SebCanet/CharlyRobotCRA4_Livet/Documentation/config grbl.png

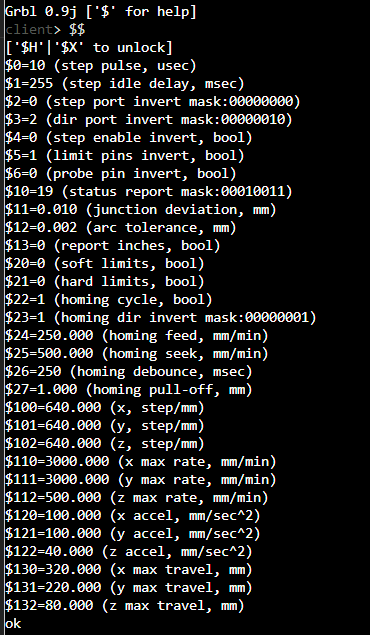
Documentation/config grbl.png
