SebCanet/CharlyRobotCRA4_Livet/Electronique/Circuit Imprimé/BOM/Liste composants.xlsx

ref | value5 | footprint | datasheet | lib | part | description | Référence Farnell
A1 | Arduino_Nano_v2.x | empreintes_CharlyRobot:Arduino_Nano | https://www.mouser.fr/datasheet/2/595/Arduino-ArduinoBoardNano-1214669.pdf | CharlyRobot | Arduino_Nano_v2.x | Arduino nano | 1848691
C1 | 1µF | empreintes_CharlyRobot:C_Rect_L7.0mm_W4.5mm_P5.00mm | http://www.farnell.com/datasheets/1955213.pdf | Device | C | Unpolarized capacitor | 1692372
C2 | 10µF | empreintes_CharlyRobot:CP_Radial_D5.0mm_P2.50mm | http://www.farnell.com/datasheets/1778119.pdf | Device | C | Polarized capacitor | 8766940
D2 | LED | empreintes_CharlyRobot:LED_D3.0mm | http://www.farnell.com/datasheets/2100363.pdf | Device | LED | Light emitting diode | 1863180 (https://www.mouser.fr/ProductDetail/Lumex/SSL-LX3044ID?qs=yJopvU1l2pYg0unLYeASnw%3D%3D&vip=1)
D3 | LED | empreintes_CharlyRobot:LED_D3.0mm | http://www.farnell.com/datasheets/2100363.pdf | Device | LED | Light emitting diode | 1863180 (https://www.mouser.fr/ProductDetail/Lumex/SSL-LX3044ID?qs=yJopvU1l2pYg0unLYeASnw%3D%3D&vip=1)
D5 | LED | empreintes_CharlyRobot:LED_D3.0mm | http://www.farnell.com/datasheets/2100363.pdf | Device | LED | Light emitting diode | 1863180 (https://www.mouser.fr/ProductDetail/Lumex/SSL-LX3044ID?qs=yJopvU1l2pYg0unLYeASnw%3D%3D&vip=1)
J1 | Connector_Conn_01x02_Male | empreintes_CharlyRobot:Bornier_2pts_L10mm_W8mm_P5mm | http://www.farnell.com/datasheets/2309835.pdf | CharlyRobot | Connector_Conn_01x02_Male | Alim drivers | 3705535 & 3705262
J10 | 350432-1 | empreintes_CharlyRobot:350432-1 | https://www.te.com/commerce/DocumentDelivery/DDEController?Action=srchrtrv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 | CharlyRobot | 350432-1 | Connecteur alim | 285353 (https://www.mouser.fr/ProductDetail/TE-Connectivity/350432-1?qs=DGLPHxYUs4knzFTLCKnSkg%3D%3D)
J2 | Connector_Conn_01x08_Male | empreintes_CharlyRobot:Bornier_8pins | https://www.te.com/commerce/DocumentDelivery/DDEController?Action=srchrtrv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 | CharlyRobot | Connector_Conn_01x08_Male | Connecteur drivers | 3705407 & 3705316 (https://www.mouser.fr/ProductDetail/TE-Connectivity/1986375-2?qs=LkCCp0h5EVj8QNNndTdIkA==&vip=1)
J3 | Connector_Conn_01x08_Male | empreintes_CharlyRobot:Bornier_8pins | https://www.te.com/commerce/DocumentDelivery/DDEController?Action=srchrtrv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 | CharlyRobot | Connector_Conn_01x08_Male | Connecteur FDC | 3705407 & 3705316 (https://www.mouser.fr/ProductDetail/TE-Connectivity/1986375-2?qs=LkCCp0h5EVj8QNNndTdIkA==&vip=1)
J4 | Connector_Conn_01x08_Male | empreintes_CharlyRobot:Bornier_8pins | https://www.te.com/commerce/DocumentDelivery/DDEController?Action=srchrtrv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 | CharlyRobot | Connector_Conn_01x08_Male | Connecteur aux | 3705407 & 3705316 (https://www.mouser.fr/ProductDetail/TE-Connectivity/1986375-2?qs=LkCCp0h5EVj8QNNndTdIkA==&vip=1)
J5 | Connector_Raspberry_Pi_2_3 | empreintes_CharlyRobot:PinSocket_2x20_P2.54mm_Horizontal | http://www.farnell.com/datasheets/2550265.pdf | CharlyRobot | Connector_Raspberry_Pi_2_3 | 2.54 mm pitch 2x20 40 Pin Double Row Female Right Angle Header Socket | 1668400
Q1 | BS170 | empreintes_CharlyRobot:TO-92_Inline_Wide_large | http://www.fairchildsemi.com/ds/BS/BS170.pdf | Transistor_FET | BS170 | 0.5A Id, 60V Vds, N-Channel MOSFET, TO-92 | 1017687
Q2 | IRF9540N | empreintes_CharlyRobot:TO-220-3_INVERSE | http://www.irf.com/product-info/datasheets/data/irf9540n.pdf | Transistor_FET | IRF9540N | -23A Id, -100V Vds, HEXFET P-Channel MOSFET, TO-220 | 8648603
R1 | 330 | empreintes_CharlyRobot:R_Axial_DIN0207_L6.3mm_D2.5mm_P10.16mm_Horizontal | http://www.farnell.com/datasheets/2861447.pdf | Device | R | Resistor | 9339418
R2 | 2.7k | empreintes_CharlyRobot:R_Axial_DIN0207_L6.3mm_D2.5mm_P10.16mm_Horizontal | http://www.farnell.com/datasheets/2860633.pdf | Device | R | Resistor | 9341641
R3 | 1k | empreintes_CharlyRobot:R_Axial_DIN0207_L6.3mm_D2.5mm_P10.16mm_Horizontal | http://www.farnell.com/datasheets/2861447.pdf | Device | R | Resistor | 9339051
R4 | 330 | empreintes_CharlyRobot:R_Axial_DIN0207_L6.3mm_D2.5mm_P10.16mm_Horizontal | http://www.farnell.com/datasheets/2861447.pdf | Device | R | Resistor | 9339418
R5 | 10k | empreintes_CharlyRobot:R_Axial_DIN0207_L6.3mm_D2.5mm_P10.16mm_Horizontal | http://www.farnell.com/datasheets/2861447.pdf | Device | R | Resistor | 9339060
R6 | 2.2k | empreintes_CharlyRobot:R_Axial_DIN0207_L6.3mm_D2.5mm_P10.16mm_Horizontal | http://www.farnell.com/datasheets/2860633.pdf | Device | R | Resistor | 9341536
R7 | 1k | empreintes_CharlyRobot:R_Axial_DIN0207_L6.3mm_D2.5mm_P10.16mm_Horizontal | http://www.farnell.com/datasheets/2861447.pdf | Device | R | Resistor | 9339051
R8 | 2.2k | empreintes_CharlyRobot:R_Axial_DIN0207_L6.3mm_D2.5mm_P10.16mm_Horizontal | http://www.farnell.com/datasheets/2860633.pdf | Device | R | Resistor | 9341536
R9 | 1k | empreintes_CharlyRobot:R_Axial_DIN0207_L6.3mm_D2.5mm_P10.16mm_Horizontal | http://www.farnell.com/datasheets/2861447.pdf | Device | R | Resistor | 9339051
TP1 | TestPoint | empreintes_CharlyRobot:TestPoint_Pad_D3.0mm | ~ | CharlyRobot | TestPoint | test point | /
TP2 | TestPoint | empreintes_CharlyRobot:TestPoint_Pad_D3.0mm | ~ | CharlyRobot | TestPoint | test point | /
TP3 | TestPoint | empreintes_CharlyRobot:TestPoint_Pad_D3.0mm | ~ | CharlyRobot | TestPoint | test point | /
U1 | LM317_TO3 | empreintes_CharlyRobot:TO-220-3_Horizontal_TabDown | http://www.ti.com/lit/ds/symlink/lm317.pdf | Regulator_Linear | LM317_TO3 | 1.5A 35V Adjustable Linear Regulator, TO-3 | 9756027 (https://www.mouser.fr/ProductDetail/STMicroelectronics/LM317T?qs=swDD%252BF%252Bps7c8uLyY%252B3mJJw%3D%3D)
U2 | regulateur_buck | empreintes_CharlyRobot:regulateur_buck |  | CharlyRobot | regulateur_buck | Régulateur buck | https://www.itead.cc/lm2596-dc-dc-buck-converter-step-down-power-module-output-1-25v-35v.html
U3 | regulateur_buck | empreintes_CharlyRobot:regulateur_buck |  | CharlyRobot | regulateur_buck | Régulateur buck | https://www.itead.cc/lm2596-dc-dc-buck-converter-step-down-power-module-output-1-25v-35v.html
