SebCanet/CharlyRobotCRA4_Livet/Documentation/Liste materiel.xlsx

Matériel pour le projet Charly Robot
Composant | Nombre | Prix unitaire (€) | Prix total (€) | Lien
Driver DRI0043 | 3 | 20 | 60 | https://www.gotronic.fr/art-commande-moteur-pas-a-pas-dri0043-25551.htm
PCB | 1 | 10 | 10 | -
Arduino Nano | 1 | 15 | 15 | https://fr.farnell.com/arduino/a000005/arduino-nano-carte-d-eval/dp/1848691
Regulateur buck | 2 | 1.5 | 3 | https://www.itead.cc/lm2596-dc-dc-buck-converter-step-down-power-module-output-1-25v-35v.html
Condensateur 10µF 35v | 1 | 0.3 | 0.3 | https://fr.farnell.com/panasonic-electronic-components/eca1vad100x/condensateur-10-f-35v-20/dp/8766940
Condensateur 1µF | 1 | 0.52 | 0.52 | https://fr.farnell.com/epcos/b32529c0105j000/condensateur-1-f-63v-5-pet-potted/dp/1692372
Resistance 1KΩ 1/4W | 3 | 0.25 | 0.75 | https://fr.farnell.com/multicomp/mcf-0-25w-1k/resistance-couche-carbon-1k-0/dp/9339051
Resistance 330Ω 1/4W | 2 | 0.25 | 0.5 | https://fr.farnell.com/multicomp/mcf-0-25w-330r/resistance-couche-carbon-330r/dp/9339418
Resistance 2,7kΩ 1/4W | 1 | 0.38 | 0.38 | https://fr.farnell.com/multicomp/mf25-2k7/resistance-2-7k-0-25w-1/dp/9341641
Resistance 10kΩ 1/4W | 1 | 0.25 | 0.25 | https://fr.farnell.com/multicomp/mcf-0-25w-10k/resistance-couche-carbon-10k-0/dp/9339060
Resistance 2,2kΩ 1/4W | 2 | 0.38 | 0.76 | https://fr.farnell.com/multicomp/mcf-0-25w-10k/resistance-couche-carbon-10k-0/dp/9339060
LED 3mm | 3 | 0.35 | 1.05 | https://fr.farnell.com/broadcom-limited/hlmp-y502-f0000/led-3mm-green-40mcd-573nm/dp/1863180
Connecteur 350432-1 alimentation | 1 | 0.94 | 0.94 | https://fr.farnell.com/amp-te-connectivity/350432-1/embase-mate-n-lok-9p/dp/285353
Bornier 8 pins | 3 | 2.3 | 6.9 | https://fr.farnell.com/phoenix-contact/1755794/embase-male-verticalee-ci-8v-5/dp/3705316
Bornier 2pins | 1 | 0.52 | 0.52 | https://fr.farnell.com/phoenix-contact/1755736/embase-male-verticalee-ci-2v-5/dp/3705262
Socket 40pins Raspberry | 1 | 5.76 | 5.76 | https://fr.farnell.com/samtec/ssw-120-02-g-d-ra/embase-2-54mm-coudee-double-40voies/dp/1668400
Régulateur LM-317 | 1 | 0.57 | 0.57 | https://fr.farnell.com/stmicroelectronics/lm317t/regulateur-ajust-1-2-37v-to-220/dp/9756027
Mosfet P IRF9540N | 1 | 0.84 | 0.84 | https://fr.farnell.com/infineon/irf9530npbf/trans-mosfet-canal-p-to-220-100v/dp/8648603
Mosfet N BS170 | 1 | 0.33 | 0.33 | https://fr.farnell.com/on-semiconductor/bs170/transistor-mosfet-n-to-92/dp/1017687
Connecteur USB B | 1 | 1 | 1 | https://fr.farnell.com/wurth-elektronik/61400416121/embase-usb-2-0-type-b-cms/dp/1642035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
Cable mini USB | 1 | 4 | 4 | https://fr.farnell.com/roline/11-02-8708/cable-usb-2-0-a-male-mini-b-male/dp/2807838?st=cable%20mini%20usb
Rapsberry Pi 3 | 1 | 33 | 33 | https://fr.farnell.com/raspberry-pi/raspberrypi3-modb-1gb/sbc-raspberry-pi-3-mod-b-1gb-ram/dp/2525226
Total | 22 |  | 146.37
Eléments à fabriquer
Composant | Nombre | Méthode | Fichier
Plaque de support | 1 | Découpe laser | planche charlyrobot cra4.svg
Bloc fixation plaque | 1 | Impression 3d | bloc alu noir maj_mdf3mm.stl
Support connecteur USB int | 1 | Impression 3d | connecteur int.stl
Support connecteur USB ext | 1 | Impression 3d | connecteur ext.stl
