SebCanet/CharlyRobotCRA4_Livet/Pieces/Decoupe laser/Plaque support/planche charlyrobot cra4 v4 inkscape.dxf

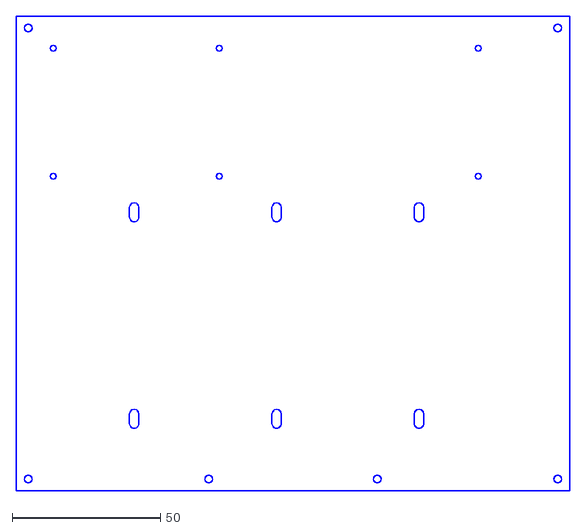
[picture p73: CAD file, 2026-11-11]
Pieces/Decoupe laser/Plaque support/planche charlyrobot cra4 v4 inkscape.dxf
186.4 x 160.0
