SebCanet/CharlyRobotCRA4_Livet/Pieces/Impression 3D/Support connecteur USB/connecteur_ext.stl

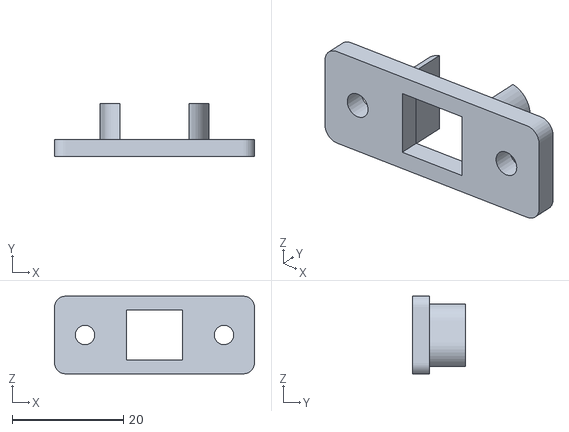
[picture p74: CAD file, 2026-11-11]
Pieces/Impression 3D/Support connecteur USB/connecteur_ext.stl
36.0 x 9.50 x 14.0
