SebCanet/CharlyRobotCRA4_Livet/Pieces/Impression 3D/Support inferieur plaque/bloc alu noir maj_mdf3mm.stl

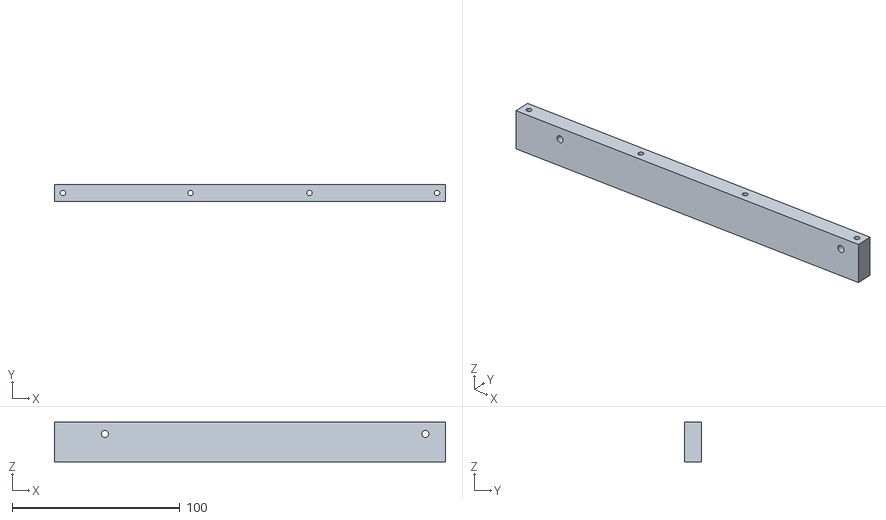
[picture p75: CAD file, 2026-11-11]
Pieces/Impression 3D/Support inferieur plaque/bloc alu noir maj_mdf3mm.stl
233.0 x 10.0 x 23.6
