SebCanet/CharlyRobotCRA4_Livet/Pieces/Impression 3D/Support connecteur USB/connecteur int.stl

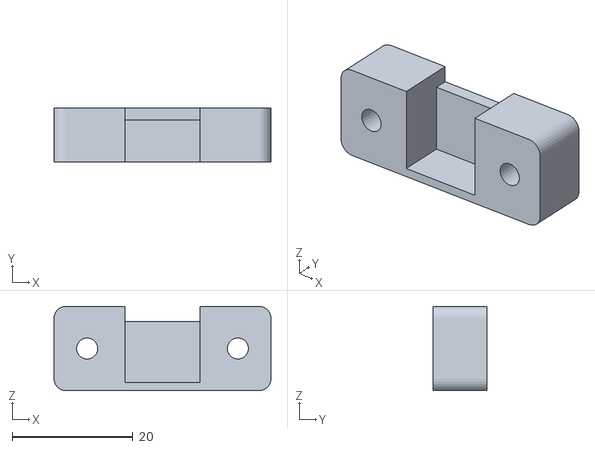
[picture p76: CAD file, 2026-11-11]
Pieces/Impression 3D/Support connecteur USB/connecteur int.stl
36.0 x 9.00 x 14.0
