SebCanet/CharlyRobotCRA4_Livet/Documentation/Installation et configuration de GRBL sur Arduino.pdf

### Installation et configuration de GRBL sur Arduino

### pour le Charly Robot

I. Installation de GRBL sur Arduino

Prérequis : un PC avec l’IDE Arduino d’installé, une carte Arduino Nano et le fichier grbl_charlyrobot.zip disponible dans Logiciels/GRBL.

1- Ouvrir Arduino puis aller dans l’onglet Croquis/Inclure une bibliothèque/Ajouter la bibliothèque .ZIP…

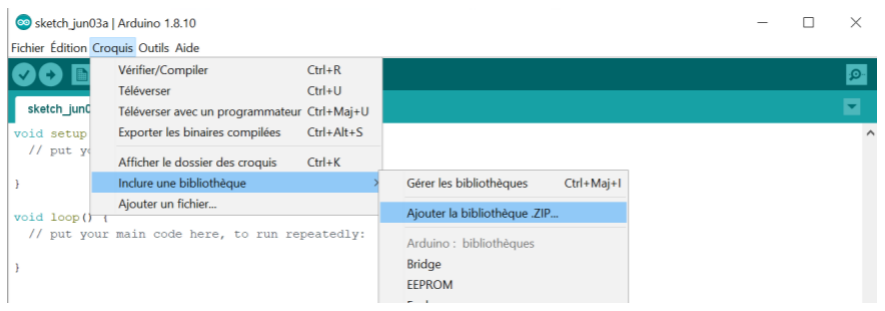
[picture p87: figure]

2- Sélectionner le fichier GRBL.zip disponible dans Logiciels/GRBL pour installer la bibliothèque GRBL.

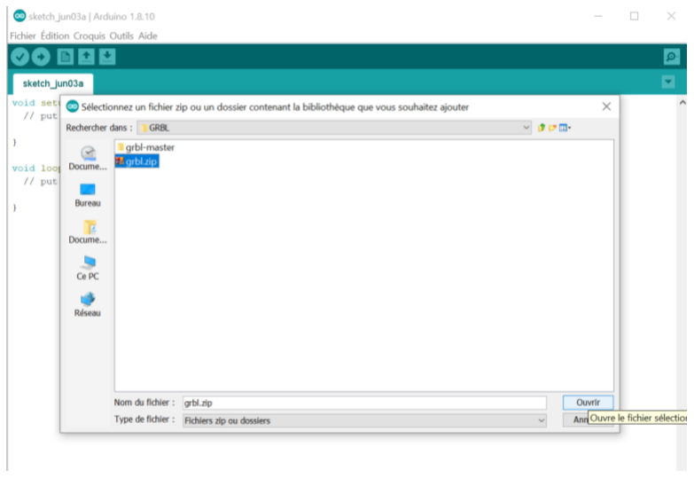
[picture p88: figure]

3- Ouvrir le menu Fichier/Exemples/grbl et sélectionner grblUpload.

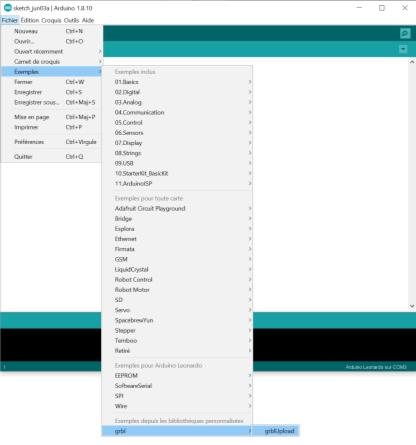
[picture p89: figure]

4- Une fenêtre avec grblUpload doit s’ouvrir, il faut ensuite sélectionner l’Arduino en allant dans Outils/Type de carte et sélectionner Arduino Nano.
Dans Outils/Processeur s’assurer d’avoir « ATmega328 ».
Enfin dans Outils/Port, sélectionner le port COM correspondant à la carte (généralement le dernier de la liste).

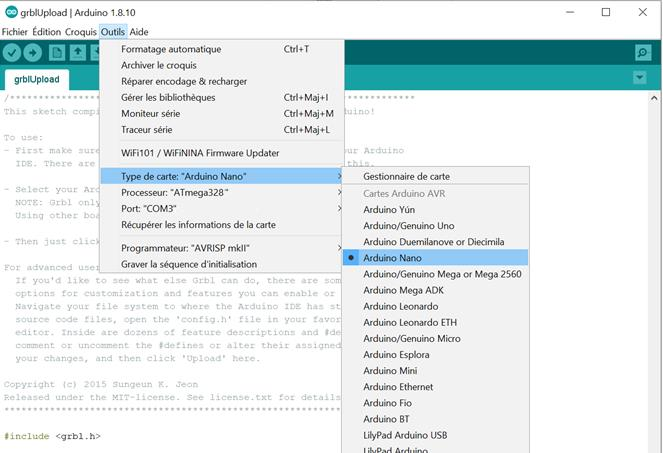
[picture p90: figure]

5- Cliquer ensuite sur le bouton Téléverser (bouton flèche) ou Croquis/Téléverser.

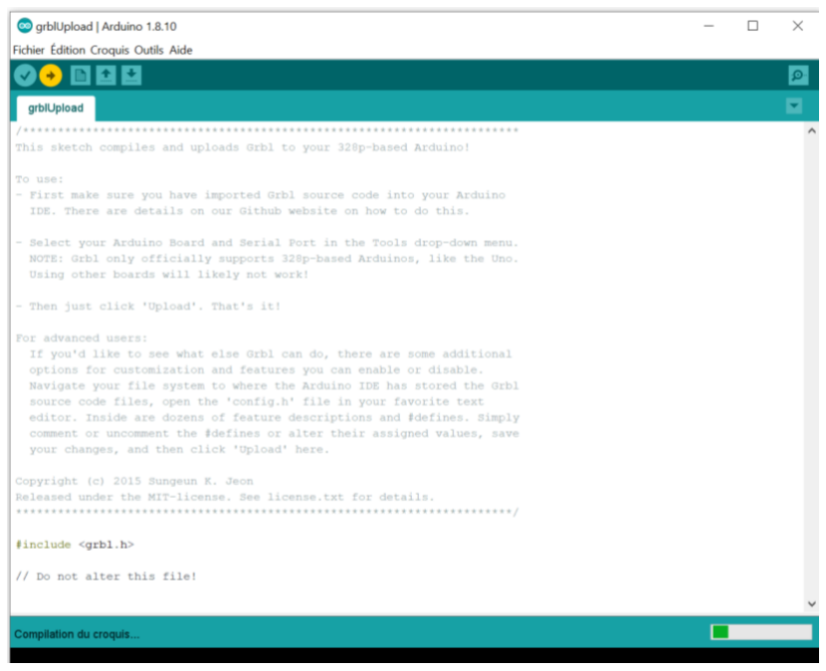
[picture p91: figure]

L’IDE Arduino vas compiler le programme puis l’envoyer dans l’Arduino Nano, il est possible que des messages d’erreurs apparaissent dans la console mais ceux-ci ne doivent pas empêcher le téléversement correcte du programme.

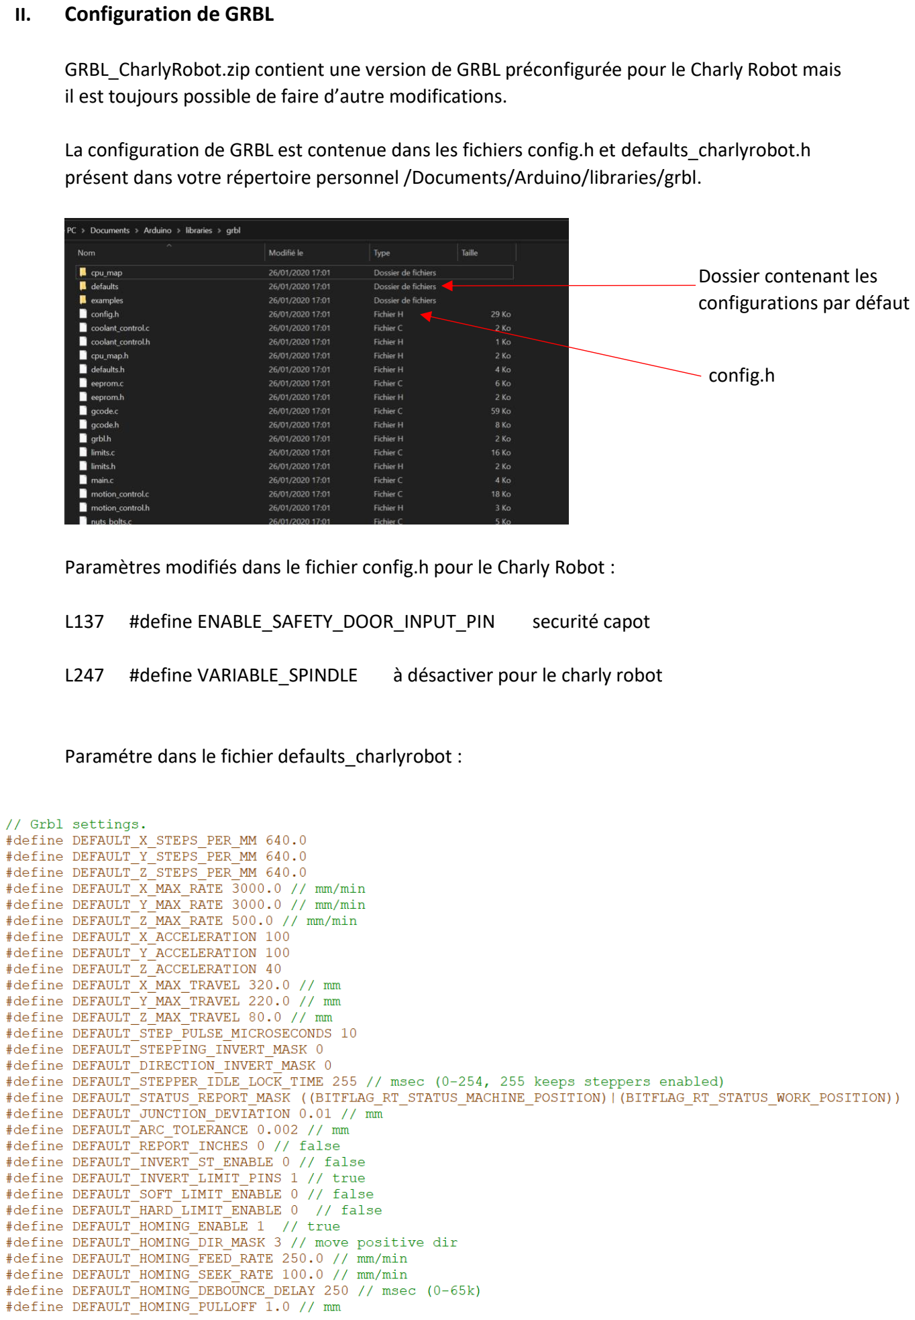
[picture p92: page 3]

II. | Configuration de GRBL
| GRBL_CharlyRobot.zip contient une version de GRBL préconfigurée pour le Charly Robot mais il est toujours possible de faire d’autre modifications.
| La configuration de GRBL est contenue dans les fichiers config.h et defaults_charlyrobot.h présent dans votre répertoire personnel /Documents/Arduino/libraries/grbl.

Paramètres modifiés dans le fichier config.h pour le Charly Robot :

L137 | #define ENABLE_SAFETY_DOOR_INPUT_PIN | securité capot
L247 | #define VARIABLE_SPINDLE | à désactiver pour le charly robot

Paramétre dans le fichier defaults_charlyrobot :

config.h

Dossier contenant les
configurations par défaut

La configuration de GRBL peut aussi se faire via une console série, la commande $$ permet de d’afficher celle-ci :

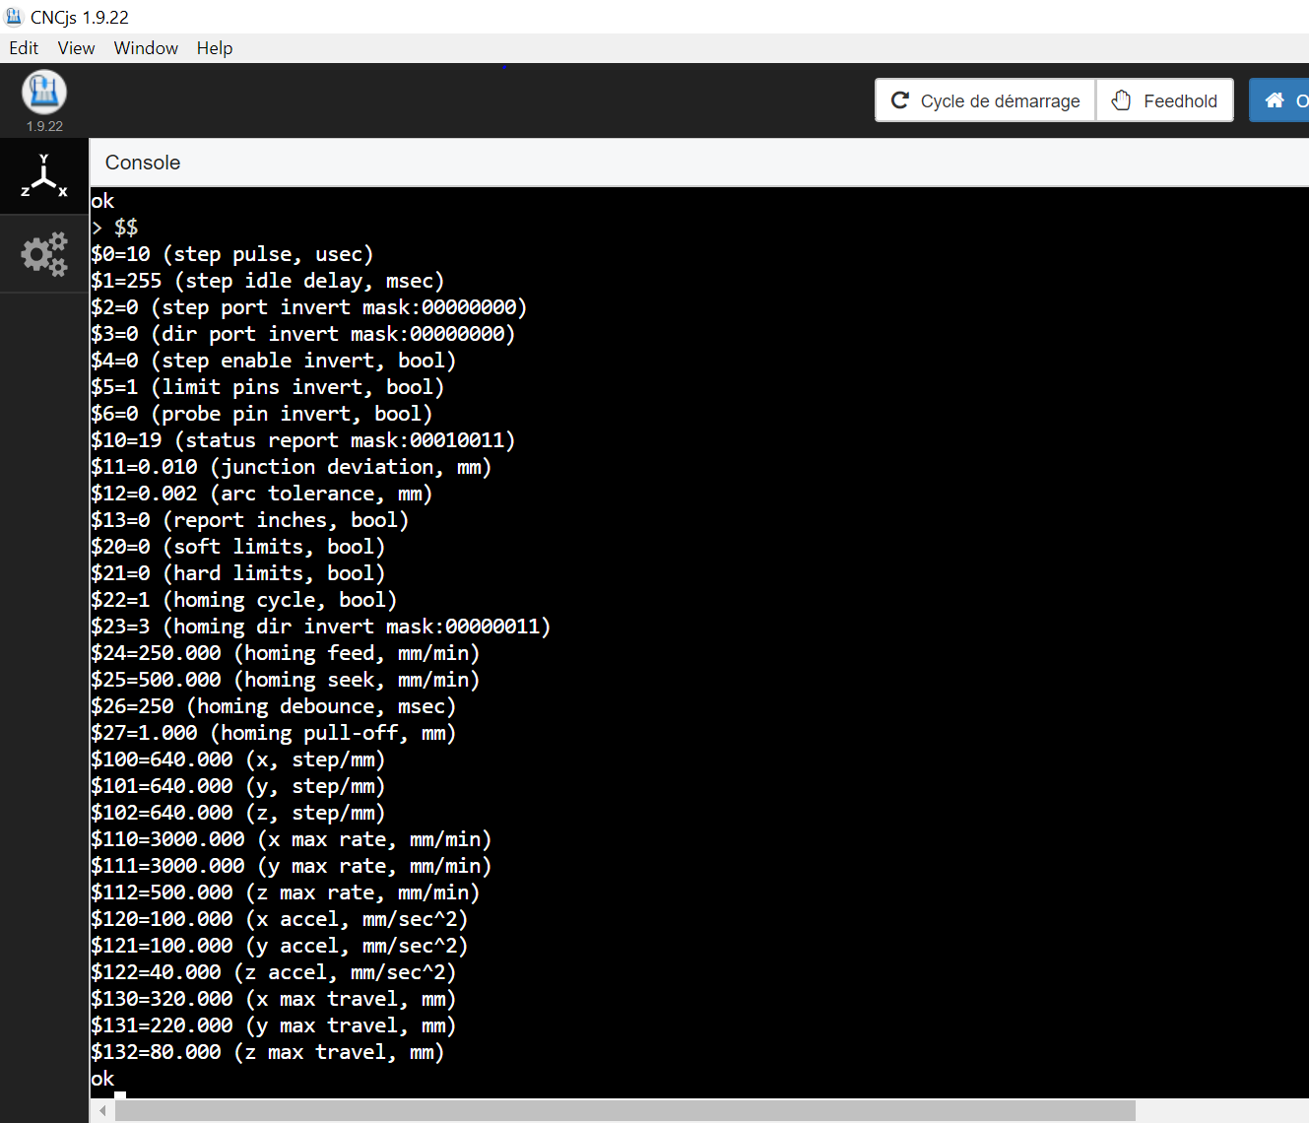
[picture p93: figure]

Il est possible de changer un paramètre en entrant $Paramètre = valeur, par exemple « $0=10 ».

Les informations sur les différents paramètres sont disponibles sur le GitHub de GRBL : https://github.com/gnea/grbl/wiki/Grbl-v1.1-Configuration

Note : La version de GRBL fournie pour le Charly Robot possède le paramètre « safety door » d’activé dans le fichier config.h. Cette fonction empêche toutes actions tant que le capot n’est pas fermé. Afin de fonction correctement, une modification du câblage doit être effectuée (voir Guide de câblage section 5) sinon le Charly robot ne fonctionne qu’avec le capot ouvert.
