SebCanet/CharlyRobotCRA4_Livet/Electronique/Circuit Imprimé/dimensions.pdf

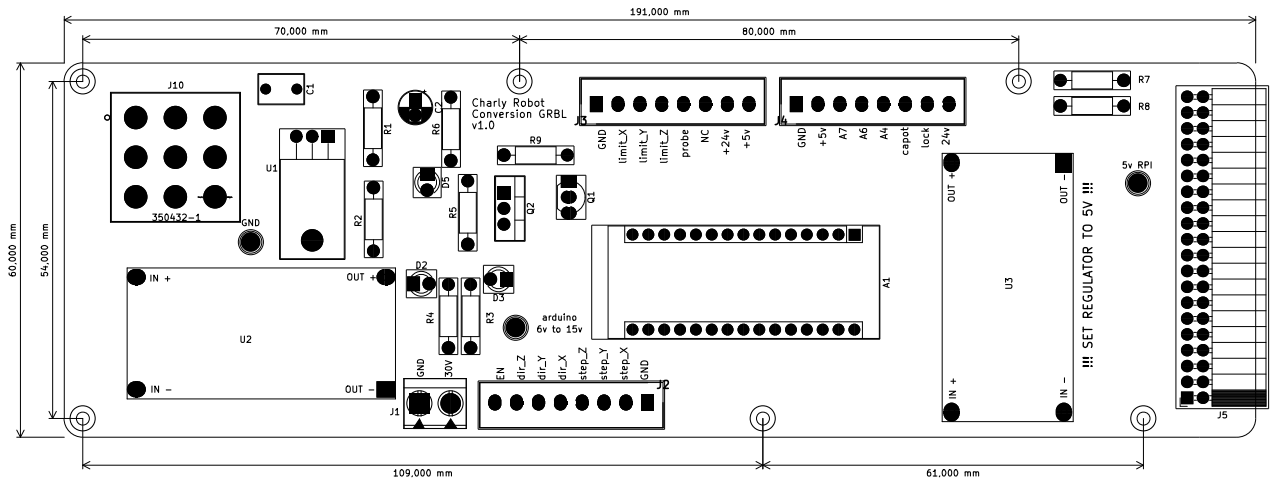
[picture p97: page 1]
