SebCanet/CharlyRobotCRA4_Livet/Electronique/Circuit Imprimé/schema carte.pdf

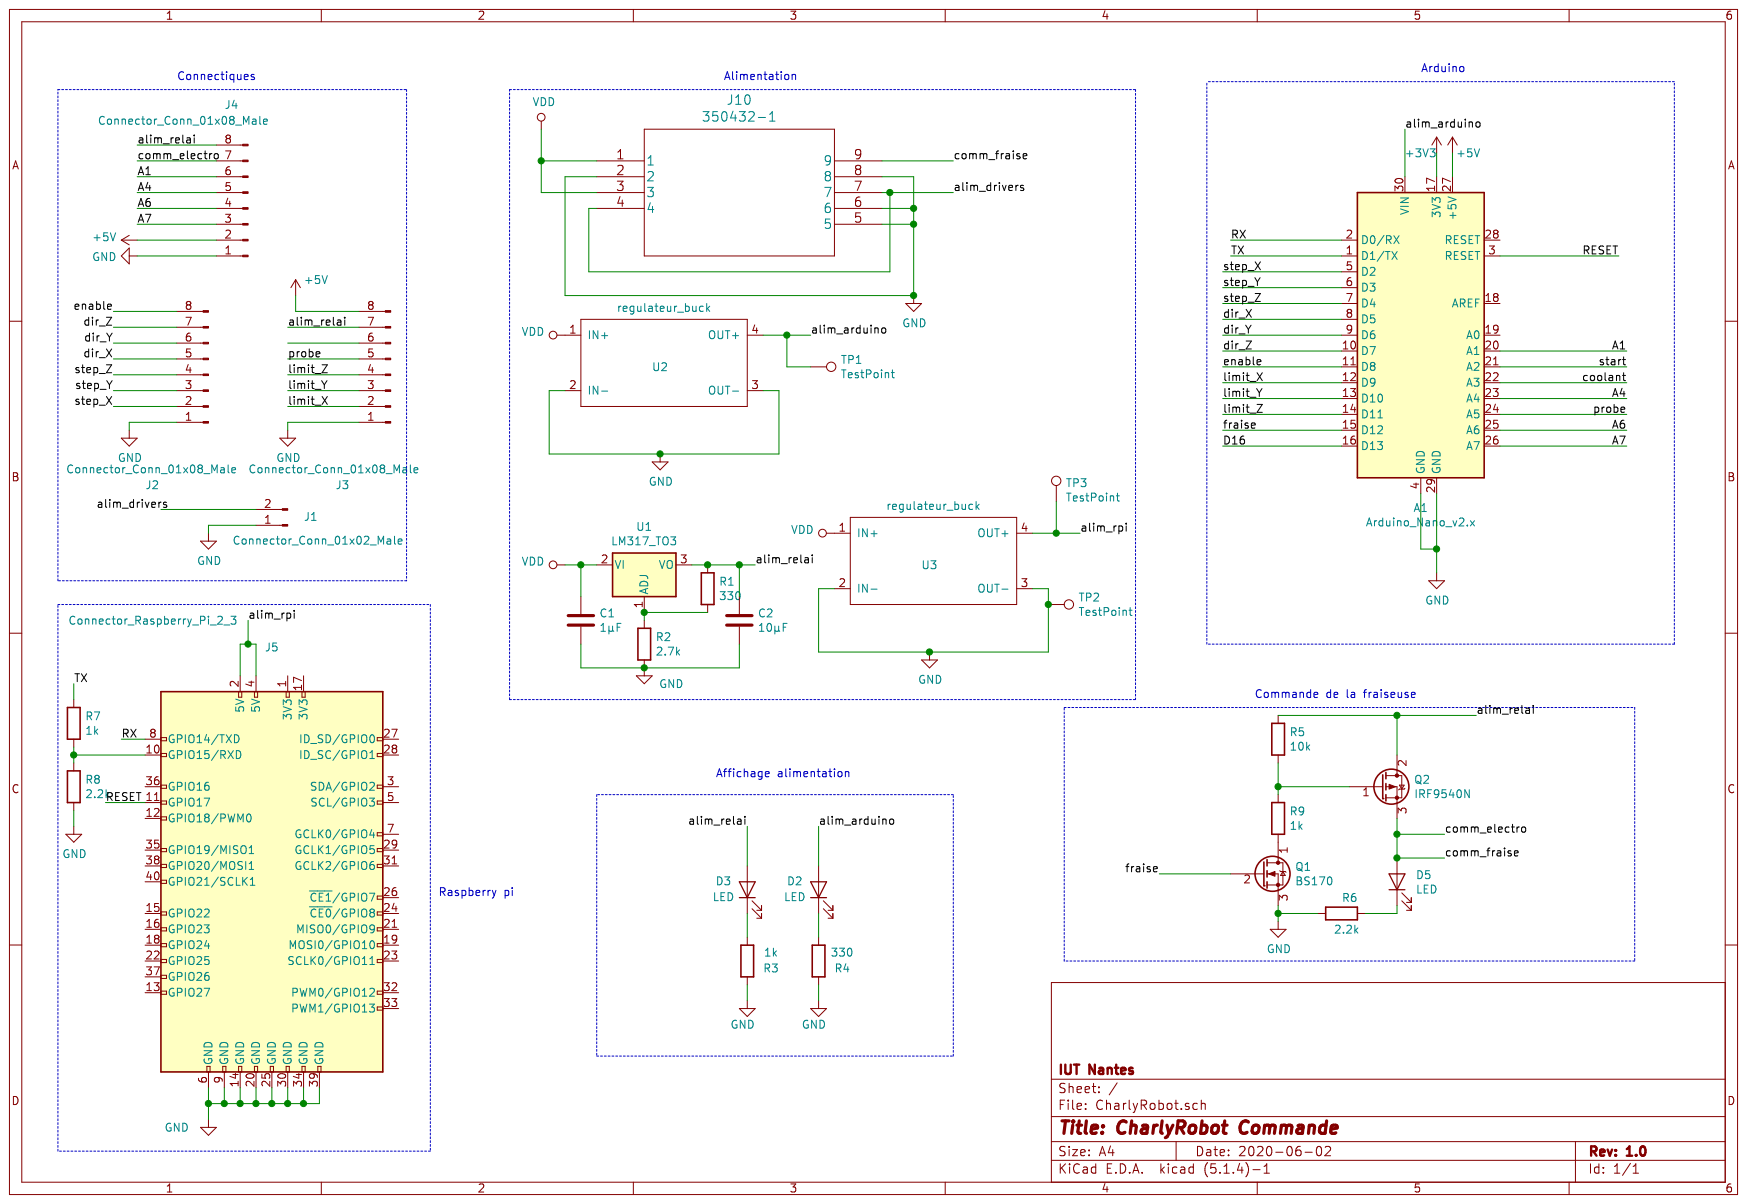
[picture p98: page 1]
