SebCanet/CharlyRobotCRA4_Livet/Electronique/Circuit Imprimé/Projet Kicad/CharlyRobot.kicad_pcb

## KiCad design Electronique/Circuit Imprimé/Projet Kicad/CharlyRobot.kicad_pcb (2026-11-11)

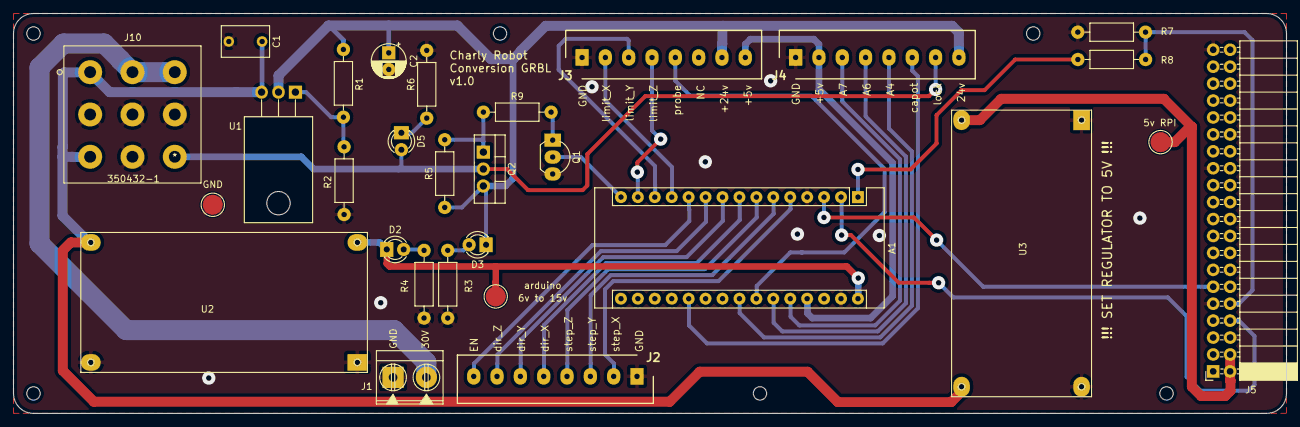
[picture p99: board CharlyRobot.kicad_pcb from above]

Board: 2 copper layers, 191.0 x 60.0 mm, 29 parts (0 on the bottom side), 34 nets.

Parts:
5v RPI: TestPoint; TestPoint_Pad_D3.0mm
A1: Arduino_Nano_v2.x; Arduino_Nano
C1: 1µF; C_Rect_L7.0mm_W4.5mm_P5.00mm
C2: 10µF; CP_Radial_D5.0mm_P2.50mm
D2, D3, D5: LED; LED_D3.0mm
GND: TestPoint; TestPoint_Pad_D3.0mm
J1: Connector_Conn_01x02_Male; Bornier_2pts_L10mm_W8mm_P5mm
J2, J3, J4: Connector_Conn_01x08_Male; Bornier_8pins
J5: Connector_Raspberry_Pi_2_3; PinSocket_2x20_P2.54mm_Horizontal
J10: 350432-1
Q1: BS170; TO-92_Inline_Wide_large
Q2: IRF9540N; TO-220-3_INVERSE
R1, R4: 330; R_Axial_DIN0207_L6.3mm_D2.5mm_P10.16mm_Horizontal
R2: 2.7k; R_Axial_DIN0207_L6.3mm_D2.5mm_P10.16mm_Horizontal
R3, R7, R9: 1k; R_Axial_DIN0207_L6.3mm_D2.5mm_P10.16mm_Horizontal
R5: 10k; R_Axial_DIN0207_L6.3mm_D2.5mm_P10.16mm_Horizontal
R6, R8: 2.2k; R_Axial_DIN0207_L6.3mm_D2.5mm_P10.16mm_Horizontal
U1: LM317_TO3; TO-220-3_Horizontal_TabDown
U2, U3: regulateur_buck
arduino: TestPoint; TestPoint_Pad_D3.0mm

Connections:
+5V: A1.27, J3.8, J4.2
/A1: A1.20, J4.6
/A4: A1.23, J4.5
/A6: A1.25, J4.4
/A7: A1.26, J4.3
/RESET: A1.3, J5.11
/RX: A1.2, J5.8
/TX: A1.1, R7.1
/alim_arduino: A1.30, D2.1, U2.4, arduino.1
/alim_drivers: J1.2, J10.4, J10.7
/alim_relai: C2.1, D3.1, J3.7, J4.8, Q2.2, R1.1, R5.1, U1.3
/alim_rpi: 5v RPI.1, J5.2, J5.4, U3.4
/comm_electro: D5.2, J4.7, J10.9, Q2.3
/dir_X: A1.8, J2.5
/dir_Y: A1.9, J2.6
/dir_Z: A1.10, J2.7
/enable: A1.11, J2.8
/fraise: A1.15, Q1.2
/limit_X: A1.12, J3.2
/limit_Y: A1.13, J3.3
/limit_Z: A1.14, J3.4
/probe: A1.24, J3.5
/step_X: A1.5, J2.2
/step_Y: A1.6, J2.3
/step_Z: A1.7, J2.4
GND: A1.4, A1.29, C1.2, C2.2, GND.1, J1.1, J2.1, J3.1, J4.1, J5.6, J5.9, J5.14, J5.20, J5.25, J5.30, J5.34, J5.39, J10.2, J10.5, J10.6, J10.8, Q1.3, R2.2, R3.1, R4.1, R6.2, R8.2, U2.2, U2.3, U3.2, U3.3
unnamed: D2.2, R4.2
unnamed: D3.2, R3.2
unnamed: D5.1, R6.1
unnamed: J5.10, R7.2, R8.1
unnamed: Q1.1, R9.2
unnamed: Q2.1, R5.2, R9.1
unnamed: R1.2, R2.1, U1.1
VDD: C1.1, J10.1, J10.3, U1.2, U2.1, U3.1
