SebCanet/CharlyRobotCRA4_Livet/(notices)

Notices in the files:
Logiciels/GRBL/grbl_charlyrobot/config.h:
Grbl is free software: you can redistribute it and/or modify
it under the terms of the GNU General Public License as published by
the Free Software Foundation, either version 3 of the License, or
(at your option) any later version.
parts and their libraries:
Copyright 2016 Accelerated Designs. All rights reserved.
